batterylabunipi/Modular_Battery_Emulator/README.md

# Modular_Battery_Emulator
Modular battery emulator for the development and functional testing of Battery Management Systems: the cell emulator
