batterylabunipi/Modular_Battery_Emulator/board_cell_emulator_V1/Schema.pdf

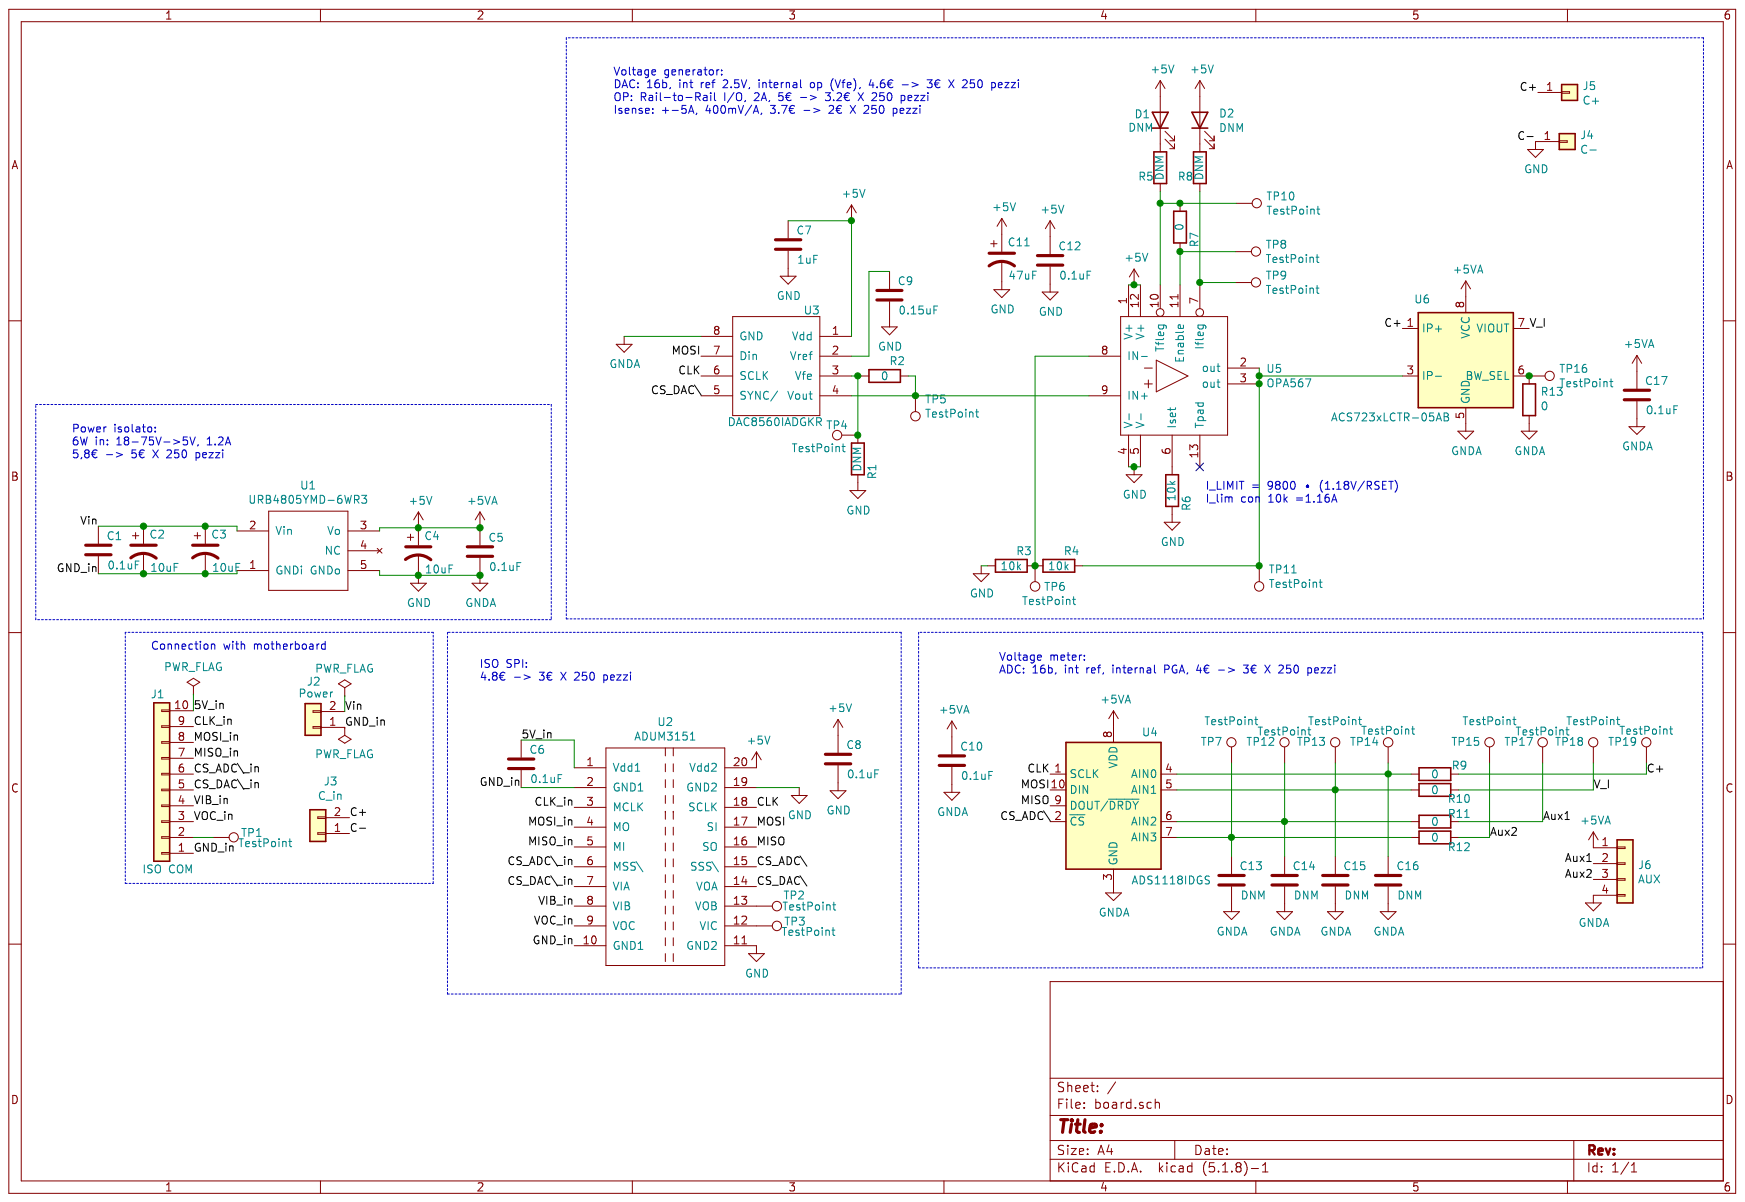
[picture p1: page 1]
