batterylabunipi/Modular_Battery_Emulator/board_cell_emulator_V1/board.kicad_pcb

## KiCad design board_cell_emulator_V1/board.kicad_pcb (2022-02-17)

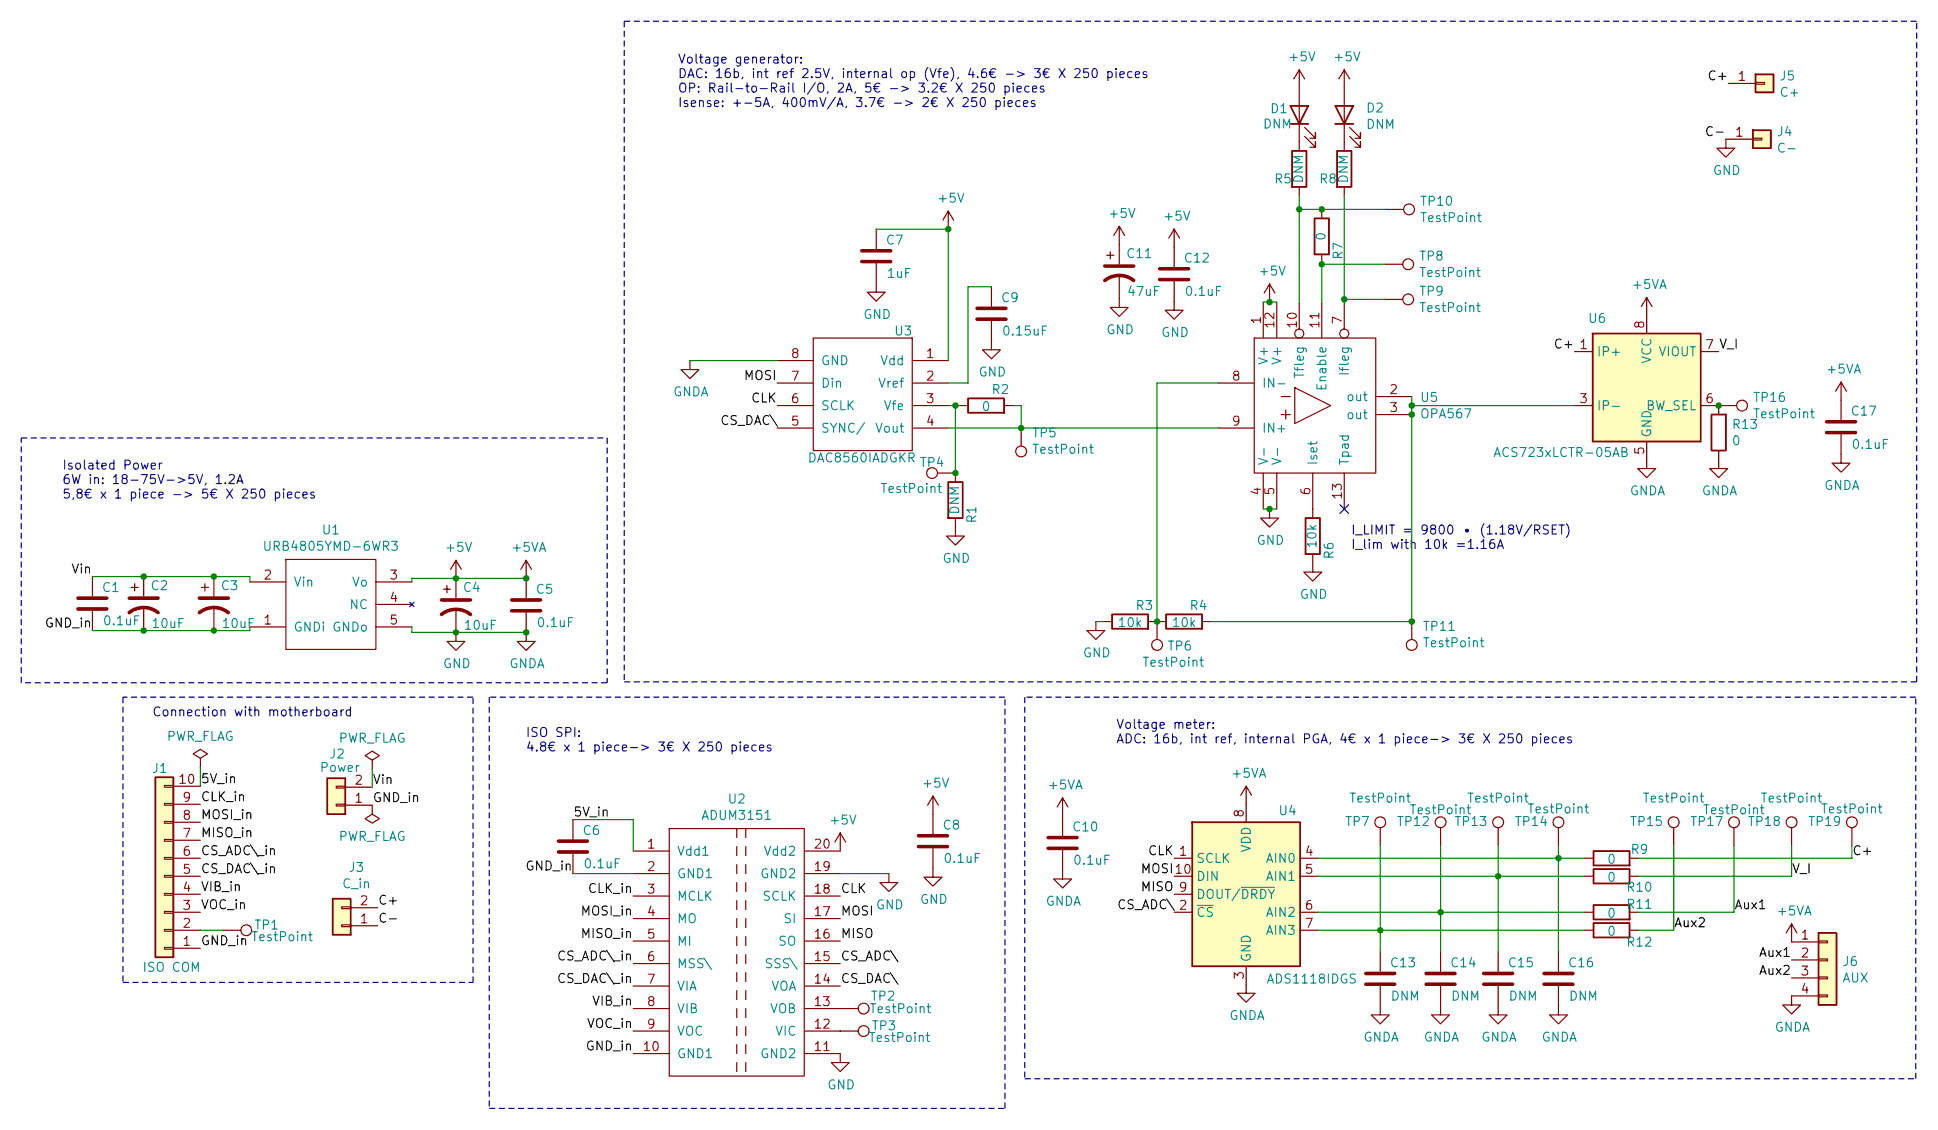
[picture p2: schematic board.sch]

Parts:
C1, C5, C6, C8, C10, C12, C17: 0.1uF; C_0805_HandSoldering; Digi 1276-6840-1-ND
C2, C3, C4: 10uF; CP_Elec_6.3x7.7; Digi 399-18132-1-ND
C7: 1uF; C_0805_HandSoldering; Digi 1276-6471-1-ND
C9: 0.15uF; C_0805_HandSoldering; Digi 1276-6476-1-ND
C11: 47uF; CP_Elec_10x10.5; Digi 493-9631-1-ND
C13, C14, C15, C16: DNM; C_0805_HandSoldering; Digi 1276-6840-1-ND
D1, D2: DNM; D_0805
J1: ISO COM; Pin_Header_Straight_1x10_Pitch2.54mm
J2: Power; Pin_Header_Straight_1x02_Pitch2.54mm
J3: C_in; Pin_Header_Straight_1x02_Pitch2.54mm
J4: C-; Banana_Jack_1Pin
J5: C+; Banana_Jack_1Pin
J6: AUX; Pin_Header_Straight_1x04_Pitch2.54mm
R1, R5, R8: DNM; C_0805_HandSoldering
R2, R7, R9, R10, R11, R12, R13: 0; C_0805_HandSoldering
R3, R4, R6: 10k; C_0805_HandSoldering; Digi P10KDACT-ND
TP1, TP2, TP3, TP4, TP5, TP6, TP7, TP8, TP9, TP10, TP11, TP12, TP13, TP14, TP15, TP16, TP17, TP18, TP19: TestPoint; Pin_Header_Straight_1x01_Pitch2.54mm
U1: URB4805YMD-6WR3; Digi 2725-URB4805YMD-6WR3-ND
U2: ADUM3151; SSOP-20_5.3x7.2mm_Pitch0.65mm; Digi ADUM3151BRSZ-RL7CT-ND
U3: DAC8560IADGKR; MSOP-8_3x3mm_Pitch0.65mm; Digi 296-49165-1-ND
U4: ADS1118IDGS; MSOP-10_3x3mm_Pitch0.5mm; Digi 296-38850-1-ND
U5: OPA567; Texas_S-PVQFN-N12_ThermalVias; Digi 296-18697-1-ND
U6: ACS723xLCTR-05AB; SOIC-8_3.9x4.9mm_Pitch1.27mm; Digi 620-1641-1-ND

Connections:
+5V: C4.1, C5.1, C7.1, C8.1, C10.1, C11.1, C12.1, C17.1, D1.2 (A), D2.2 (A), J6.1, U1.3 (Vo), U2.20 (Vdd2), U3.1 (Vdd), U4.8 (VDD), U5.1 (V+), U5.12 (V+), U6.8 (VCC)
/5V_in: C6.1, J1.10, U2.1 (Vdd1)
/Aux1: J6.2, R11.2, TP17.1
/Aux2: J6.3, R12.2, TP15.1
/C+: J3.2, J5.1, R9.2, TP19.1, U6.1 (IP+), U6.2 (IP+)
/CLK: U2.18 (SCLK), U3.6 (SCLK), U4.1 (SCLK)
/CLK_in: J1.9, U2.3 (MCLK)
/CS_ADC\: U2.15 (SSS\), U4.2 (~CS)
/CS_ADC\_in: J1.6, U2.6 (MSS\)
/CS_DAC\: U2.14 (VOA), U3.5 (SYNC/)
/CS_DAC\_in: J1.5, U2.7 (VIA)
/GND_in: C1.2, C2.2, C3.2, C6.2, J1.1, J2.1, U1.1 (GNDi), U2.2 (GND1), U2.10 (GND1)
/MISO: U2.16 (SO), U4.9 (DOUT/~DRDY)
/MISO_in: J1.7, U2.5 (MI)
/MOSI: U2.17 (SI), U3.7 (Din), U4.10 (DIN)
/MOSI_in: J1.8, U2.4 (MO)
/VIB_in: J1.4, U2.8 (VIB)
/VOC_in: J1.3, U2.9 (VOC)
/V_I: R10.2, TP18.1, U6.7 (VIOUT)
/Vin: C1.1, C2.1, C3.1, J2.2, U1.2 (Vin)
GND: C4.2, C5.2, C7.2, C8.2, C9.2, C10.2, C11.2, C12.2, C13.2, C14.2, C15.2, C16.2, C17.2, J3.1, J4.1, J6.4, R1.2, R3.1, R6.2, R13.1, U1.5 (GNDo), U2.11 (GND2), U2.19 (GND2), U3.8 (GND), U4.3 (GND), U5.4 (V-), U5.5 (V-), U6.5 (GND)
unnamed: C9.1, U3.2 (Vref)
unnamed: C13.1, R12.1, TP7.1, U4.7 (AIN3)
unnamed: C14.1, R11.1, TP12.1, U4.6 (AIN2)
unnamed: C15.1, R10.1, TP13.1, U4.5 (AIN1)
unnamed: C16.1, R9.1, TP14.1, U4.4 (AIN0)
unnamed: D1.1 (K), R5.1
unnamed: D2.1 (K), R8.1
unnamed: J1.2, TP1.1
unnamed: R1.1, R2.1, TP4.1, U3.3 (Vfe)
unnamed: R2.2, TP5.1, U3.4 (Vout), U5.9 (IN+)
unnamed: R3.2, R4.1, TP6.1, U5.8 (IN-)
unnamed: R4.2, TP11.1, U5.2 (out), U5.3 (out), U6.3 (IP-), U6.4 (IP-)
unnamed: R5.2, R7.1, TP10.1, U5.10 (Tfleg)
unnamed: R6.1, U5.6 (Iset)
unnamed: R7.2, TP8.1, U5.11 (Enable)
unnamed: R8.2, TP9.1, U5.7 (Ifleg)
unnamed: R13.2, TP16.1, U6.6 (BW_SEL)
unnamed: TP2.1, U2.13 (VOB)
unnamed: TP3.1, U2.12 (VIC)

Notes on the sheet:
I_LIMIT = 9800 • (1.18V/RSET) I_lim with 10k =1.16A
Isolated Power 6W in: 18-75V->5V, 1.2A 5,8€ x 1 piece -> 5€ X 250 pieces
Voltage generator: DAC: 16b, int ref 2.5V, internal op (Vfe), 4.6€ -> 3€ X 250 pieces OP: Rail-to-Rail I/O, 2A, 5€ -> 3.2€ X 250 pieces Isense: +-5A, 400mV/A, 3.7€ -> 2€ X 250 pieces
Voltage meter: ADC: 16b, int ref, internal PGA, 4€ x 1 piece-> 3€ X 250 pieces
ISO SPI: 4.8€ x 1 piece-> 3€ X 250 pieces
Connection with motherboard

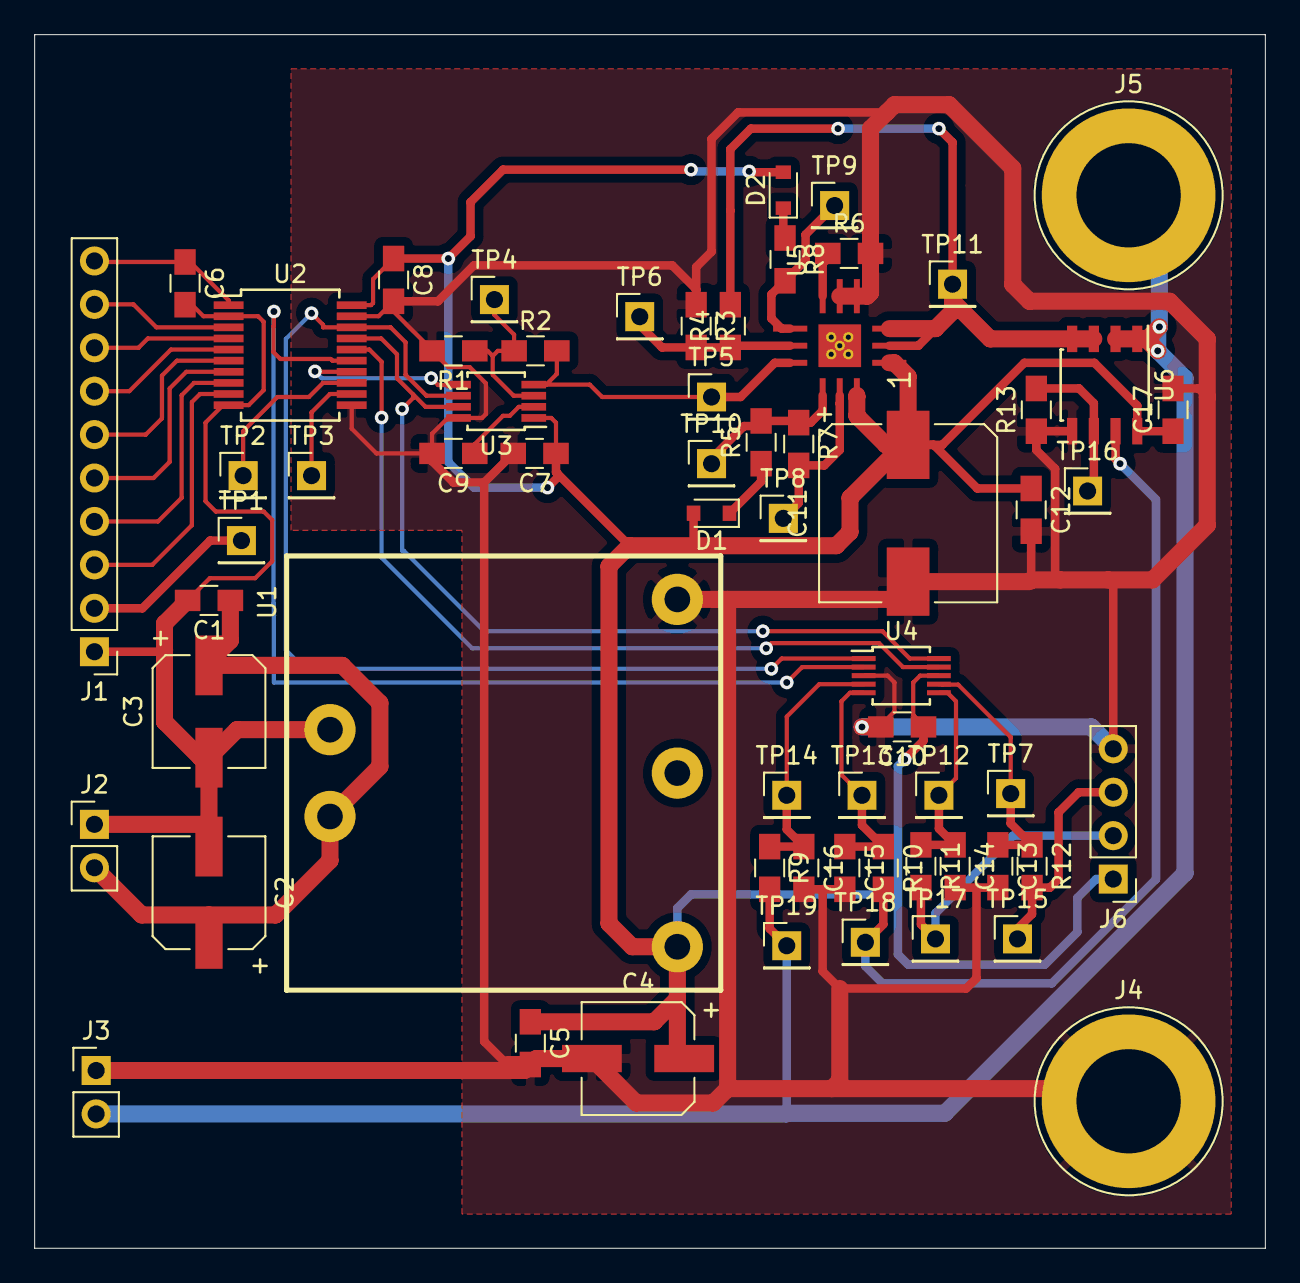
[picture p3: board board.kicad_pcb from above]

Board: 2 copper layers, 72.0 x 71.0 mm, 63 parts (0 on the bottom side), 40 nets.
