batterylabunipi/Modular_Battery_Emulator/(threads)

Thread 1 (2025-02-13):

Project Status - Is it possible to build this project?

Flydroid, 2025-02-13:
Hi batterylab unipi,

I have been with interest reading the papers from your lab and was happy to find that you have published code and design files.
Having worked with BMS for a few years I know of the challange to develop a good battery cell emulator.

For a personal project with a fairly large battery pack (2p12sx28p) and BMS have been researching for a good emulator design.

I would like to ask on the status of this repo? Are the code and design files complete?
I have experience both with embedded development on the stm32h7 as well as with pcb design and would be interested in continuing the work.

Best regards,
Jonathan
